CHIP-8-Org/Docs/README.md

# CHIP-8 STM32

The purpose of this project is to build a CHIP-8 and S-CHIP emulator capable of running on an STM32 microcontroller.
