CHIP-8-Org/Docs/report/report.tex

\documentclass[a4paper]{article}

\usepackage{showcode/showcode}
\usepackage{multicol}
\usepackage{blindtext}
\usepackage{amssymb}
\usepackage{amsthm}
\usepackage{mathtools}
\usepackage{bm}

\usepackage[a4paper]{geometry}
\usepackage[hidelinks]{hyperref}
\usepackage{eurosym}
\usepackage{caption, subcaption}
\usepackage{tikz, circuitikz}
\usepackage{pgf-umlcd, pgf-umlsd}
\usepackage[italian]{babel} % FIXME
\usepackage[utf8]{inputenc}
\usepackage[T1]{fontenc}
\usepackage[normalem]{ulem}
\usepackage[titletoc]{appendix}
\usepackage{listings}

\lstdefinelanguage{CHIP8}{
  morekeywords={loop, again, sprite, key, random, if, then},
  sensitive=true,
}

\lstset{
  language=CHIP8,
  basicstyle=\ttfamily,
  keywordstyle=\bfseries,
  frame=single,
  numbers=left,
  stepnumber=1,
  numbersep=5pt,
  breaklines=true,
  breakatwhitespace=true,
}

\renewcommand{\umltextcolor}{black}
\renewcommand{\umldrawcolor}{black}
\renewcommand{\umlfillcolor}{white}

\definecolor{type}{RGB}{132, 42, 17}

\textwidth=450pt
\oddsidemargin=0pt
\textheight=665pt
\voffset=-50pt

\begin{document}

\begin{titlepage}
    \begin{center}
        

        \vspace*{1.75cm}

        \LARGE

        \textbf{MSc in Computer Science} \\
        at University of Milan

        \vspace*{1cm}

        \huge
        Emulatore CHIP-8 su STM32

        \large Relazione per il progetto di PROS, \\
        corso tenuto da \textbf{Danilo Bruschi}

        \normalsize
        \vspace*{4cm}

        \begin{minipage}[t]{0.47\textwidth}
            {\large \href{federico.bruzzone@studenti.unimi.it}{federico.bruzzone@studenti.unimi.it}} \vspace{1em}  \\
            {\large \href{lorenzo.ferrante1@studenti.unimi.it}{lorenzo.ferrante1@studenti.unimi.it}} \vspace{1em}  \\
            {\large \href{andrea.longoni3@studenti.unimi.it}{andrea.longoni3@studenti.unimi.it}} \vspace{1em}  \\
        \end{minipage}
        \hfill
        \begin{minipage}[t]{0.47\textwidth}\raggedleft
            {\large \textbf{Federico Bruzzone}} \\
            \vspace{1em}
            {\large \textbf{Lorenzo Ferrante}} \\
            \vspace{1em}
            {\large \textbf{Andrea Longoni}}
        \end{minipage}

        \vfill
        Anno accademico 2022/2023

    \end{center}
\end{titlepage}
\setlength{\parindent}{0pt}
\setlength{\parskip}{0.8em}

\tableofcontents
\listoffigures
\listoftables

\clearpage

\begin{center}
\fbox{
    \begin{minipage}{0.9\textwidth}
    \footnotesize\itshape
    Abbiamo deciso di creare un'organizzazione GitHub per rendere accessibile il codice
    sorgente del nostro progetto ad altri programmatori open-source coinvolti con lo sviluppo
    di emulatori e con la community online di CHIP-8.
    \\
    \\
    Link all'organizzazione:
    \begin{itemize}
        \item Macchina virtuale: \url{https://github.com/CHIP-8-Org/Core}
        \item Port su STM32: \url{https://github.com/CHIP-8-Org/STM32-Port}
        \item Documentazione: \url{https://github.com/CHIP-8-Org/Docs}
    \end{itemize}
    \end{minipage}
}
\end{center}

\section{Introduzione}

CHIP-8 è un linguaggio di programmazione creato a metà degli anni '70
da Joseph Weisbecker per semplificare lo sviluppo di videogiochi per
microcomputer a 8 bit. I programmi CHIP-8 vengono interpretati da una
macchina virtuale che è stata estesa parecchie volte nel corso degli
anni, tra le versioni più adottate citiamo S-CHIP e la più recente
XO-CHIP.

La semplicità dell'interprete in aggiunta alla sua lunga storia e
popolarità hanno fatto sì che emulatori e programmi CHIP-8 vengano
realizzati ancora oggi.
Nel corso degli anni molti videogiochi storici sono stati riscritti
in CHIP-8 tra cui Pong, Space Invaders e Tetris.

Lo scopo del progetto è quello di realizzare un emulatore CHIP-8 e
S-CHIP in grado di funzionare su un microcontrollore STM32.

In questo documento ci riferiremo alla macchina virtuale che
interpreta programmi CHIP-8 con "interprete". Mentre utilizzeremo
"emulatore" per indicare l'interprete assieme ad una sua
implementazione (o "port"), ovvero un programma che gestisce
l'audio, il video, l'input da tastiera e interagisce con l'API della
macchina virtuale.

\section{Stato dell'arte}

Al giorno d'oggi risulta difficile ottenere un numero esatto di utenti che
utilizzano CHIP-8,un buon indicatore può essere il topic "chip8" di GitHub
che raggruppa quasi un migliaio di repository.

Tra queste la più popolare è Octo, un'implementazione scritta in JavaScript
capace di eseguire la versione base di CHIP-8, S-CHIP e XO-CHIP nel browser.
La repository è mantenuta da John Earnest, l'inventore di XO-CHIP che nel 2014
ha riportato in vita CHIP-8 modernizzandolo e aggiungendo nuove funzionalità.

Inoltre ogni anno viene organizzata la Octojam, una game jam dove ogni partecipante
prova a sviluppare un videogioco per CHIP-8 (o per le sue estensioni) partendo da zero.

Grazie al suo instruction set ridotto e alla sua limitata richiesta di risorse hardware
è stato portato su un elevato numero di piattaforme, tra cui il Game Boy Color, calcolatrici
grafiche serie HP 48 e Emacs (il famoso editor di testo).

Sebbene CHIP-8 e S-CHIP siano stati tradizionalmente implementati tramite software
esistono anche implementazioni hardware. Ne citiamo una in particolare scritta nel
linguaggio Verilog per schede FPGA.

\clearpage

\section{Hardware}\label{sec:hardware}

\begin{figure}[h!t]
    \begin{subfigure}[b]{0.45\textwidth}
        \begin{center}
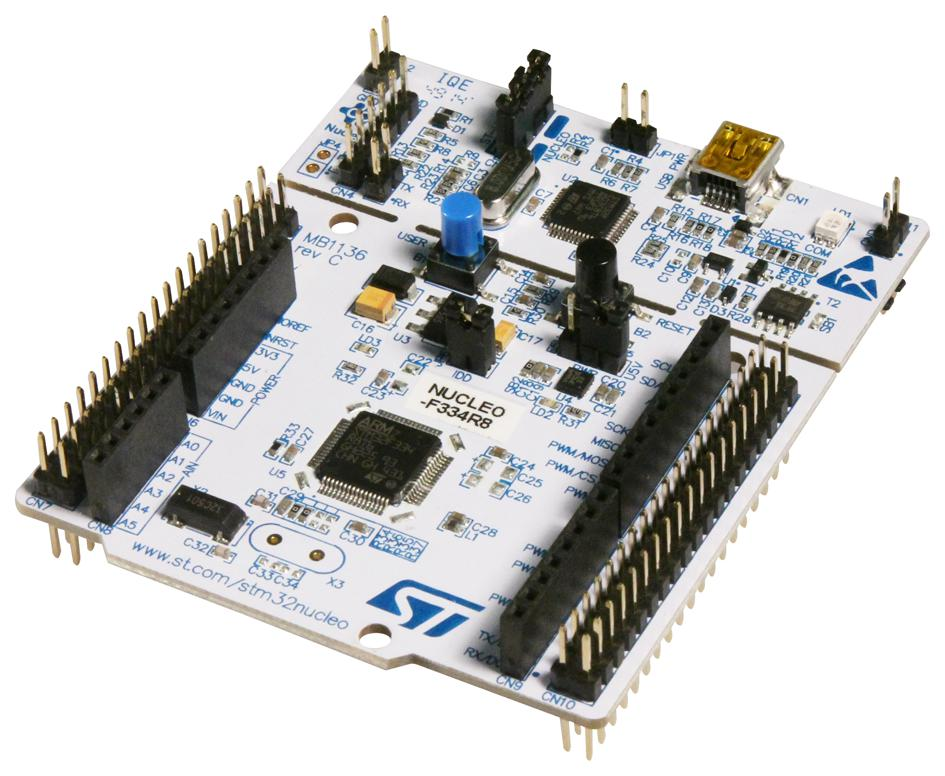
[picture p1: report/figures/stm32f334.jpg]
            
        \end{center}
        \caption{Il microcontrollore \texttt{STM32F334R8T6}.}
        \label{fig:stm32f334}
    \end{subfigure}
    \hfill
    \begin{subfigure}[b]{0.45\textwidth}
        \begin{center}
            \begin{tikzpicture}[x=0.015cm, y=0.015cm, scale=0.50, transform shape]
                \input{figures/stm32f334.tex}
            \end{tikzpicture}
        \end{center}
        \caption{Pinout del microcontrollore \texttt{STM32F334R8T6}.}
        \label{fig:pinout_stm32}
    \end{subfigure}
\end{figure}

Il componente hardware principale è il microcontrollore \texttt{STM32F334R8T6}
(Fig. \ref{fig:stm32f334}), equipaggiato con un processore ARM Cortex-M4
da 72 MHz, 16 Kb di SRAM e 64 Kb di memoria flash. Abbiamo deciso di utilizzare
questa scheda anziché quella fornitaci durante il corso (\texttt{STM32L053R8T6})
perché quest'ultima offriva una quantità di SRAM troppo limitata (solo 8 Kb).

In particolare le ROM dei giochi CHIP-8 possono arrivare a pesare fino a 3.5 Kb per questo
motivo è stato necessario utilizzare una scheda leggermente più potente.

\begin{figure}[h!t]
    \begin{subfigure}[b]{0.45\textwidth}
        \begin{center}
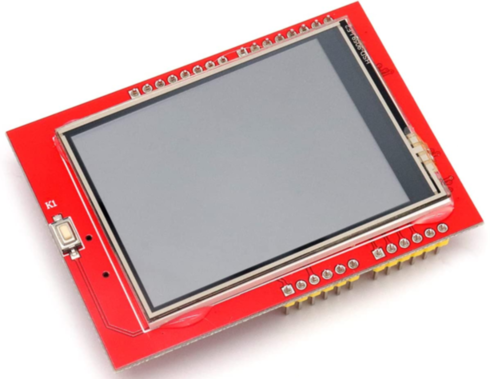
[picture p2: report/figures/ili9341.png]
            
        \end{center}
        \caption{Lo schermo ILI9341.}
        \label{fig:ili9341}
    \end{subfigure}
    \hfill
    \begin{subfigure}[b]{0.45\textwidth}
        \begin{center}
            \begin{tikzpicture}[x=0.015cm, y=0.015cm, scale=0.65, transform shape]
                \input{figures/ili9341.tex}
            \end{tikzpicture}
        \end{center}
        \caption{Pinout dello schermo \texttt{ILI9341}.}
        \label{fig:pinout_ili}
    \end{subfigure}
\end{figure}

Per quanto riguarda lo schermo dell'emulatore abbiamo optato per un display TFT LCD
a colori retroilluminato (Fig. \ref{fig:ili9341}) basato sul controller \texttt{ILI9341}.
Il display ha una dimensione di 2.4 pollici, una risoluzione di 320$\times$240 px e
al suo interno è presente un lettore di schede microSD integrato.

\clearpage

\begin{figure}[h!t]
    \begin{subfigure}[b]{0.45\textwidth}
        \begin{center}
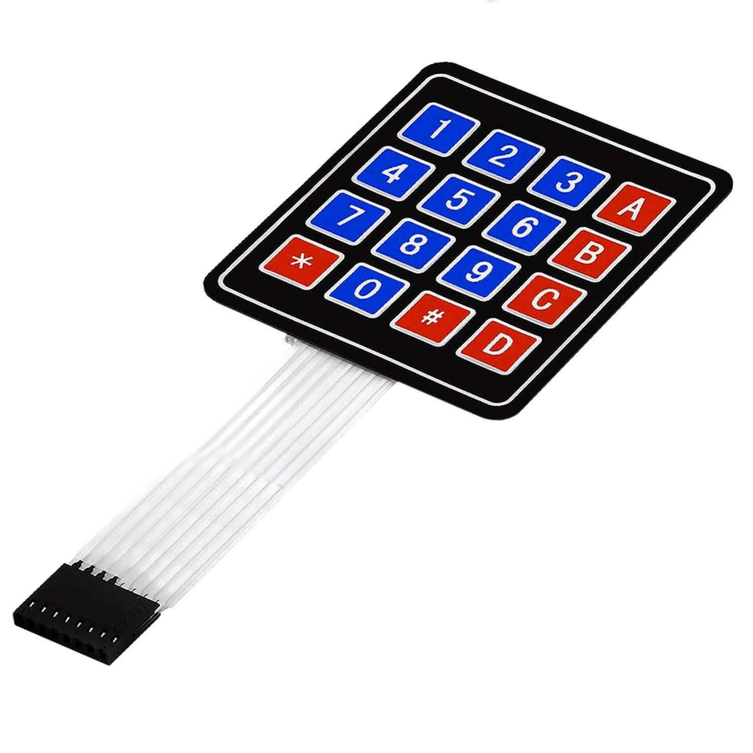
[picture p3: report/figures/4x4_keypad.jpeg]
            
        \end{center}
        \caption{Il tastierino matriciale 4$\times$4.}
        \label{fig:4x4_keypad}
    \end{subfigure}
    \hfill
    \begin{subfigure}[b]{0.45\textwidth}
        \begin{center}
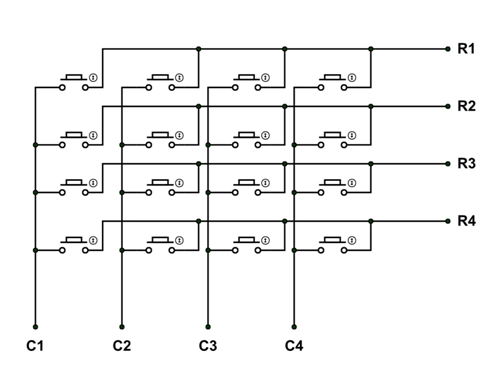
[picture p4: report/figures/4x4_keypad_structure.png]
            
        \end{center}
        \caption{Struttura del tastierino matriciale 4$\times$4.}
        \label{fig:4x4_keypad_structure}
    \end{subfigure}
\end{figure}

Per poter interagire con l'emulatore abbiamo utilizzato un tastierino matriciale 4$\times$4
(Fig. \ref{fig:4x4_keypad}) analogo alla tastiera originale del
COSMAC VIP \cite{wikipedia:cosmacvip}, un microcomputer creato da Joseph Weisbecker appositamente per CHIP-8.

Infine, per supportare gli effetti sonori riprodotti dai videogiochi CHIP-8 abbiamo
utilizzato un beeper passivo monotono, che anche essendo un dispositivo molto semplice
adempie correttamente ai suoi compiti dato che il suono prodotto da un emulatore CHIP-8
deve avere solo un tono.

\subsection{Componenti utilizzati e relativi costi}

\begin{table}[h!t] % [ht]
    \centering
    \begin{tabular}{|llll|l|}
        \hline
        \multicolumn{1}{|l|}{\textbf{Descrizione}}          & \multicolumn{1}{l|}{\textbf{Modello}}       & \multicolumn{1}{l|}{\textbf{Costo unitario}} & \textbf{Unità} & \textbf{Costo} \\ \hline
        \multicolumn{1}{|l|}{Microcontrollore}       & \multicolumn{1}{l|}{STM32 F334R8T6}         & \multicolumn{1}{l|}{14.99}                   & 1               & 14.99          \\ \hline
        \multicolumn{1}{|l|}{Schermo}                & \multicolumn{1}{l|}{ILI9341 2.4"}           & \multicolumn{1}{l|}{6.50}                    & 1               & 6.50           \\ \hline
        \multicolumn{1}{|l|}{Tastierino}          & \multicolumn{1}{l|}{Matrix keypad 4$\times$4} & \multicolumn{1}{l|}{3.99}                    & 1               & 3.99           \\ \hline
        \multicolumn{1}{|l|}{Beeper}                 & \multicolumn{1}{l|}{}                       & \multicolumn{1}{l|}{0.99}                    & 1               & 0.99           \\ \hline
        \multicolumn{1}{|l|}{Cablaggio} & \multicolumn{1}{l|}{}                       & \multicolumn{1}{l|}{4.99}                    & 1               & 4.99           \\ \hline
        \multicolumn{1}{|l|}{Interruttore e altri materiali} & \multicolumn{1}{l|}{}       & \multicolumn{1}{l|}{4.99}                    & 1               & 4.99           \\ \hline
        \multicolumn{1}{|l|}{Scocca} & \multicolumn{1}{l|}{GW42002}                       & \multicolumn{1}{l|}{9.99}                    & 1               & 9.99           \\ \hline
        \multicolumn{4}{|r|}{\textbf{Totale}}                                                      & 46.50\euro    \\ \hline
    \end{tabular}
    \caption{
        Materiali utilizzati per la realizzazione del progetto.
    }
    \label{tab:components}
\end{table}

In Tabella \ref{tab:components} è possibile vedere i componenti utilizzati per la
realizzazione del progetto. I costi indicati provengono da negozi online come Amazon e eBay.

\subsection{Schema di collegamento} \label{subsubsec:collegamenti}

\textbf{Legenda dei colori in Figura \ref{fig:schema}}

\begin{multicols}{2}
\begin{itemize}
    \item \textcolor{green}{Verde}: Schermo
    \item \textcolor{blue}{Blu}: Scheda microSD
    \item \textcolor{magenta}{Magenta}: Tastierino
    \item \textcolor{orange}{Arancione}: Beeper
    \item \textcolor{cyan}{Ciano}: Reset
    \item \textcolor{black}{Nero}: GND
    \item \textcolor{red}{Rosso}: Alimentazione
\end{itemize}
\end{multicols}

\clearpage

\begin{figure}[h!t]
    \begin{center}
        
    \end{center}
    \caption{
        Schema dei collegamenti.
    }
    \label{fig:schema}
\end{figure}

In Figura \ref{fig:schema} è possibile vedere lo schema di collegamento
dei componenti hardware realizzato utilizzando il software KiCad.
Il display e il lettore microSD integrato sono stati collegati al microcontrollore
attraverso il pinout standard degli Shields di Arduino, un'interfaccia hardware che permette
di collegare una scheda Arduino ad un modulo esterno.

Il tastierino matriciale 4$\times$4 è stato collegato al microcontrollore tramite 8 pin GPIO.
In particolare i 4 pin relativi alle righe (\texttt{R1}, \texttt{R2}, \texttt{R3}, \texttt{R4})
sono stati impostati in modalità \texttt{GPIO\_MODE\_IT\_RISING} (interrupt rising edge).

Quando un pin GPIO viene configurato come sorgente di interrupt sul fronte di salita
il segnale di interrupt è generato quando il pin passa da basso (0) ad alto (1), risultando
particolarmente utile per intercettare il cambiamento dello stato di un
pulsante quando viene premuto.

Invece, i 4 pin relativi alle colonne (\texttt{C1}, \texttt{C2}, \texttt{C3}, \texttt{C4})
sono stati impostati in modalità \texttt{GPIO\_MODE\_OUTPUT\_PP} (push-pull output) per
consentire l'invio dell'interrupt alla pressione di un tasto, dato che chiudendo il circuito
si permette alla corrente proveniente dal pin GPIO di fluire verso i pin di interrupt.
Successivamente viene identificato il tasto premuto, questo meccanismo verrà elaborato
nella sezione \ref{subsubsec:keypad}.

\clearpage

Infine, il beeper è stato collegato al microcontrollore tramite un pin GPIO e GND.
Quest'ultimo è stato impostato in modalità \texttt{GPIO\_MODE\_OUTPUT\_PP} (push-pull output)
per permettere l'invio di un segnale al beeper.

\section{Software}

Il nostro software si divide in due componenti principali: l'interprete CHIP-8 e
l'infrastruttura necessaria per "portarlo" sul microcontrollore STM32, ovvero l'interfaccia
con lo schermo e i gestori per la scheda microSD, per il keypad e per il beeper.

\subsection{Interprete CHIP-8} \label{subsec:intreprete}

\begin{Listing}[h!t] % [ht]
    \centering
    \showc*[.8\textwidth]{chip8_struct.c}
    \caption{La struct che rappresenta lo stato della macchina virtuale.}
    \label{chip8_struct}
\end{Listing}

Abbiamo deciso di scrivere l'interprete da zero e per farlo è stato necessario consultare
le specifiche (de facto standard) che definiscono il comportamento di un interprete CHIP-8
\cite{cowgod:chip8} e S-CHIP \cite{cowgod:schip}.

L'interprete ha un'architettura basata su registri e possiede 4 Kb di memoria, 16 registri
general purpose, un registro per gli indirizzi di memoria, un registro per il delay timer,
un registro per il sound timer, uno stack per gestire le chiamate a subroutine, uno stack pointer
e un program counter.

Il delay timer viene utilizzato come cronometro mentre il sound
timer è utilizzato per gestire gli effetti sonori, quando il suo
valore è diverso da zero, l'emulatore attiva il beeper.

Ad ogni ciclo di esecuzione l'interprete effettua il fetch
dell'istruzione puntata dal program counter in memoria,
la decodifica e la esegue.

Sono supportate 45 istruzioni diverse, ciascuna delle
quali è rappresentata da uno specifico opcode in cui al suo interno
sono passati anche eventuali parametri.

Il programma è scritto in C99, non ha I/O ed è freestanding
\cite{n1256:conformance}, ovvero non dipende dalla libreria
standard del C (libc). Tutto questo è mirato a rendere l'interprete
altamente portabile.

Per rimuovere la dipendenza da libc è stato necessario includere
alcune funzioni direttamente da libgcc, trovare un modo alternativo
per implementare le asserzioni e includere una funzione ad hoc per
la generazione di numeri casuali.

Le asserzioni sono gestite tramite una macro che verifica una condizione.
Se la condizione è falsa, viene dereferenziato un puntatore a NULL, terminando
così il programma. Si è utilizzato \texttt{volatile} per evitare possibili ottimizzazioni
del compilatore. Invece per quanto riguarda la generazione di numeri casuali è stato
adottato un LCG troncato \cite{wikipedia:lcg}, un generatore di numeri pseudo-casuali
molto comune.

\clearpage

\begin{Listing}[h!t]
    \centering
    \mbox{
        \showc[.45\textwidth]{assert.c}
        \quad
        \showc[.50\textwidth]{random.c}
    }
    \caption{Implementazioni di \texttt{ASSERT} e \texttt{rand\_byte}.}
    \label{assert_rand}
\end{Listing}

Infine per testare più comodamente l'interprete abbiamo sviluppato
un semplice emulatore su desktop utilizzando SDL2
\cite{libsdl:about}, una libreria scritta in C che consente di
gestire audio, video e input da tastiera.
In seguito l'interprete è stato sottoposto ad un'apposita
test suite \cite{github:chip8-test-suite} che mira a verificare
il comportamento corretto di ciascun opcode.

\subsubsection{Gestione del timing}

Uno dei problemi principali durante lo sviluppo di un emulatore è
la gestione del timing, in particolare è necessario limitare la
"velocità" dell'emulatore bloccando temporaneamente la sua
esecuzione.

Inoltre abbiamo dovuto disaccoppiare la frequenza dell'interprete
(regolabile dal giocatore) dalla frequenza del delay timer e del
sound timer (costante a 60 Hz). Dove con frequenza dell'interprete
ci riferiamo al numero di istruzioni che esegue ogni frame.

Inizialmente abbiamo optato per la gestione di una singola istruzione per ciclo di esecuzione,
di conseguenza il ritardo del game loop risultava variabile e dipendeva dalla frequenza selezionata
dal giocatore. Per assicurare una frequenza $\mathcal{F}$ di 60 Hz i timer venivano decrementati
ogni n-esima iterazione del game loop, dove $n = \frac{\mathcal{F}}{60}$. Ad esempio se
$\mathcal{F} = 540$, i timer venivano decrementati ogni $9^{\circ}$ ciclo.

Purtroppo però questo approccio presenta un problema non trascurabile, ovvero effettua una chiamata
ad una funzione simil-sleep per un periodo molto breve dopo ogni istruzione. Ad esempio se
$\mathcal{F} = 540$, il ritardo di una sleep sarebbe solo di 1.85 ms, e questo genere di funzione
non offre una precisione simile. Per questo motivo abbiamo optato per una soluzione differente.

Abbiamo fissato il ritardo del game loop a 16.666 ms, un valore sufficientemente alto da non avere
problemi di granularità. Inoltre in questo modo otteniamo un frame rate di 60 FPS esatti.
Avendo reso il ritardo costante abbiamo dovuto rendere variabile il numero di istruzioni gestite
durante un ciclo di esecuzione. In particolare vengono gestite n istruzioni per ciclo,
dove $n = \frac{\mathcal{F}}{60}$. Ad esempio se $\mathcal{F} = 540$, vengono gestite 9 istruzioni
per ciclo. A questo punto dato che il game loop viene ripetuto con una frequenza di 60 Hz risulta
banale gestire la frequenza dei timer.

Sono state considerate anche eventuali problematiche che sarebbero potute sorgere con questo
approccio. In particolare non tutte le istruzioni impiegano lo stesso tempo per essere eseguite,
ma fortunatamente anche l'istruzione più lenta richiede una quantità trascurabile di tempo.
Ciò significa che possiamo comportarci come se tutte le istruzioni richiedessero il medesimo tempo.

\subsubsection{Ottimizzazioni}

È stato necessario introdurre delle ottimizzazioni all'interno
dell'interprete per poterlo far girare su un microcontrollore.

L'ottimizzazione principale è legata alla rappresentazione dello
schermo in memoria. Ad alto livello lo schermo può essere visto
come una matrice di 128x64 pixel monocromi. Una rappresentazione
simile occuperebbe 8192 byte, dato che ciascun pixel verrebbe
rappresentato da un byte.

Purtroppo il nostro microcontrollore ha a disposizione solamente 16 Kb di SRAM, di conseguenza
una soluzione simile non è praticabile.

\clearpage

Per questo motivo abbiamo deciso di rappresentare lo schermo come un array unidimensionale di
1024 byte, dove ciascun pixel viene rappresentato da un singolo bit. In questo modo otteniamo
un risparmio di spazio pari a ben l'87.5\%.

Questa decisione ha aggiunto però un livello di indirezione dato
che una coordinata ad alto livello sulla matrice 128x64 deve essere
mappata ad una coordinata "in memoria".

\begin{figure}[h!t]
    \begin{center}
        % \includegraphics[scale=0.3]{figures/screenopt.pdf}
        
    \end{center}
    \caption{Esempio della mappatura di un pixel.}
    \label{fig:screenopt}
\end{figure}

Un'ulteriore ottimizzazione viene resa disponibile attraverso l'API
dell'interprete sotto forma di una funzione che consente al chiamante
di controllare se l'array che rappresenta lo schermo è stato
modificato nell'ultimo ciclo di esecuzione. In questo modo la grafica
viene renderizzata dal chiamante solo quando è effettivamente
necessario.

\subsubsection{Comportamenti ambigui}

Gli interpreti CHIP-8 e S-CHIP hanno sviluppato molteplici
comportamenti ambigui nel corso degli anni. Questi cosiddetti
"quirk" variano in base alle piattaforme per cui è stato sviluppato
l'interprete. Ad esempio gli interpreti per calcolatrici HP 48
presentano un comportamento leggermente diverso durante l'esecuzione
delle istruzioni di SHIFT.

Questi comportamenti ambigui si propagano fino ai programmatori
CHIP-8 che si appoggiano a quest'ultimi e scrivono videogiochi che
non sono del tutto compatibili con interpreti più vecchi. Per evitare
questa frammentazione è necessario supportare le piattaforme
principali e i loro quirk.

Il nostro interprete supporta CHIP-8, CHIP-48, S-CHIP 1.0 e
S-CHIP 1.1, in questo modo è in grado di eseguire la stragrande
maggioranza dei videogiochi reperibili in rete.

\subsection{Porting su STM32}

Dopo aver terminato l'interprete abbiamo sviluppato un'infrastruttura per poterlo eseguire
sul microcontrollore STM32.

Come già anticipato, l'infrastruttura si compone di un'interfaccia con lo schermo,
un gestore per la scheda microSD, un gestore per il tastierino e un gestore per il beeper.

È importante ricordare che l'interprete è stato progettato per essere altamente portabile
e indipendente dalla piattaforma su cui verrà eseguito, per questo motivo non è stato necessario
apportare modifiche significative.

Tuttavia, a causa della potenza limitata della scheda la fluidità del gameplay è inferiore
rispetto alla port su SDL2 che viene eseguita su normale computer.

\clearpage

\subsubsection{Architettura software}

\begin{figure}[h!t]
    \begin{center}
        \begin{tikzpicture}[scale=0.6, transform shape]
            \input{figures/class_diagram.tex}
        \end{tikzpicture}
    \end{center}
    \caption{
       Class diagram.
    }
    \label{fig:class_diagram}
\end{figure}

In Figura \label{fig:class_diagram} è rappresentato il class diagram, il quale offre una panoramica
dell'architettura del software. Una differenza da evidenziare rispetto alla proposta iniziale
è che la classe \texttt{menù} non è più presente perché è stata integrata all'interno della
classe \texttt{main}.

\begin{figure}[h!t]
    \begin{center}
        \input{figures/sequence_diagram.tex}
    \end{center}
    \caption{
        Sequence diagram.
    }
    \label{fig:sequence_diagram}
\end{figure}

Il flusso di esecuzione dell'emulatore è mostrato in Figura \ref{fig:sequence_diagram},
per prima cosa vengono letti i nomi dei file presenti sulla scheda microSD, in seguito
si entra nel game selection loop dove il giocatore potrà selezionare un gioco, la velocità
dell'interprete e la piattaforma da emulare. Una volta selezionato il gioco si entrerà nel
game loop dove inizia la fase di emulazione vera e propria.

\subsubsection{Interfaccia con la scheda microSD}\label{subsubsec:sd}

La scheda microSD è utilizzata come memoria di massa dell'emulatore contenente i file
binari dei videogiochi CHIP-8. È stata formattata con FAT32 e viene gestita utilizzando
FatFs \cite{elm-chan:fatfs}, una libreria open source che permette di interfacciarsi
con questa tipologia di filesystem.

La comunicazione tra il microcontrollore e la scheda microSD avviene tramite il protocollo
Serial Peripheral Interface (SPI), dove il microcontrollore è configurato come
master e la scheda microSD come slave.

\subsubsection{Menù di selezione}

La selezione del gioco avviene tramite un apposito menù che lista su più pagine tutti i giochi
presenti sulla scheda microSD. Per aggiungere un gioco è sufficiente caricarlo sulla scheda
microSD e riavviare il microcontrollore, poiché il menu viene generato dinamicamente.
Inoltre, il menù permette anche di impostare la velocità e la modalità di esecuzione
dell'interprete.

L'utente interagisce con il menù attraverso il tastierino, in particolare abbiamo predisposto
dei tasti riservati per la navigazione tra le pagine, per la selezione della velocità e
della modalità di esecuzione. I tasti rimanenti vengono utilizzati per avviare specifici giochi.

Infine, per risolvere il problema degli artefatti grafici al cambio di schermata,
abbiamo implementato una funzione dedicata per "pulire" lo schermo e ottenere un effetto
di transizione da una schermata all'altra.

\subsubsection{Rendering del font}

\begin{figure}[h!t]
    \begin{center}
        
    \end{center}
    \caption{Esempio della mappatura di un carattere del font.}
    \label{fig:matrix_font}
\end{figure}

Per poter mostrare  sullo schermo  i nomi dei giochi caricati sulla scheda microSD è
necessario l'utilizzo di un font. Abbiamo scelto un font che rappresenta ciascun carattere
come una bitmap, ossia una matrice $8 \times 10$ pixel rappresentata da 10 interi ad 8 bit.

Nella Figura \ref{fig:matrix_font}, è mostrata una rappresentazione grafica di questa matrice.
Ogni riga è un intero a 8 bit, dove i bit a 1 corrispondono ai pixel neri. Ad esempio,
la prima riga è rappresentata dal numero 56, che in binario è \texttt{00111000}.

\clearpage

\subsubsection{Funzionamento del keypad}\label{subsubsec:keypad}

Inizialmente il keypad è stato gestito tramite polling, dove il microcontrollore verificava
continuamente lo stato dei pin per identificare il tasto premuto. Tuttavia, questo approccio
è stato abbandonato in favore di un approccio basato su interrupt. Il polling richiedeva
molte risorse e non garantiva un framerate stabile, poiché non riusciva a leggere tutti
i pin e completare le operazioni rimanenti entro il limite di ~16 ms imposto dal frame rate
dell'emulatore (60 FPS).

La procedura standard per gestire gli interrupt su microcontrollori STM32 coinvolge
la configurazione di un pin GPIO come sorgente di interrupt e l'implementazione di
una funzione per la gestione di un interrupt. Per poter generare un interrupt quando
un tasto viene premuto abbiamo impostato i pin di riga in modalità \texttt{GPIO\_MODE\_IT\_RISING}
e i pin di colonna in modalità \texttt{GPIO\_MODE\_OUTPUT\_PP}, come già accennato nella
sezione \ref{subsubsec:collegamenti}.

% FIXME
%
% Successivamente, viene capito quale tasto è stato premuto, leggendo il valore dei pin
% di riga e di colonna. Per fare ciò, i pin di riga sono stati impostati in modalità
% \texttt{GPIO\_MODE\_INPUT}. Come si può vedere nel listato \ref{keypad} a riga 1,
% nella routine di interrupt viene abilitato il pin di output della prima colonna e in seguito
% per ogni riga viene letto il valore del pin di input per conoscere la seconda coordinata
% del tasto premuto, e in caso sia premuto viene salvato nella struttura dati apposita
% nella macchina virtuale. Questa operazione viene ripetuta per ognuna delle quattro colonne.
% Al termine della routine di interrupt i pin di riga vengono re-impostati in modalità
% \texttt{GPIO\_MODE\_IT\_RISING} per permettere l'invio dell'interrupt alla pressione
% di un nuovo tasto.
%
% \begin{Listing}[h!t] % [ht]
%     \centering
%     \setminted[c]{escapeinside=@@}
%     \showc*[.87\textwidth]{keypad.c}
%     \caption{Gestione dell'interrupt del keypad.}
%     \label{keypad}
% \end{Listing}

\subsubsection{Interfaccia con lo schermo}

La comunicazione con il controller ILI9341 può avvenire tramite due interfacce diverse:
SPI oppure parallela ad 8 bit. L'interfaccia SPI richiede meno pin ma è più lenta
a causa del suo protocollo seriale, mentre l'interfaccia parallela è più veloce ma
richiede più pin. La decisione di quale interfaccia utilizzare viene presa direttamente
dal produttore che espone solamente alcuni dei pin del circuito integrato. Poiché il display
dovrà essere aggiornato 60 volte al secondo abbiamo deciso di acquistare la versione dello
schermo che supporta l'interfaccia parallela.

Durante la fase di inizializzazione i pin di controllo della scheda
(\texttt{LCD\_RD}, \texttt{LCD\_WR}, \texttt{LCD\_RS}, \texttt{LCD\_CS}, \texttt{LCD\_RST})
vengono impostati in modalità \texttt{GPIO\_MODE\_OUTPUT\_PP} tramite le funzioni messe a
disposizione dall'HAL.

Inoltre, prima di inviare la sequenza di inizializzazione al display, vengono disabilitati i pin
\texttt{LCD\_WR} e \texttt{LCD\_RD} e viene impostato il pin \texttt{LCD\_CS} a
\texttt{LOW} (il controller \texttt{ILI9341} è attivo basso).

Il pin \texttt{LCD\_RST} permette di resettare lo stato interno del display, per questo
motivo viene attivato e disattivato all'avvio in modo tale da impostare la scheda in uno
stato conosciuto. Questo pin rimarrà disabilitato per l'intera durata dell'esecuzione.

Nel momento in cui la scheda raggiunge uno stato conosciuto bisogna inviare una sequenza di
comandi per attivare il display, questa sequenza di inizializzazione è spiegata dettagliatamente
nel datasheet dello schermo \cite{ili9341}.

Infine, per ottimizzare le prestazioni, abbiamo deciso di modificare il modo in cui stampiamo
sullo schermo. Inizialmente la funzione che gestisce la stampa a schermo si appoggiava
all'HAL, questo purtroppo generava un overhead non trascurabile che rallentava molto
l'emulatore. Per risolvere questo problema abbiamo deciso di non appoggiarci più all'HAL e
di scrivere la funzione in bare metal.

% FIXME
%
% Per risolvere questo problema abbiamo deciso di implementare due funzioni in bare metal.
%
% Entrambe le funzioni impostano il pin GPIO che gli viene passato come argomento ad
% uno stato \texttt{LOW} o \texttt{HIGH} rispettivamente. Eseguiamo questa azione scrivendo
% nel registro BSRR (come mostrato nel capitolo 9.4.7 in \cite{STM32F334xx}) (Bit Set/Reset Register).
% Nel caso della funzione \texttt{HIGH}, quando si scrive un 1 in un bit del registro BSRR,
% il corrispondente pin viene impostato su \textit{high}, mentre se si scrive un 0, il pin viene
% lasciato invariato. Nel caso di quella \texttt{LOW}, si accede sempre al registro BSRR,
% ma questa volta si utilizzano i bit superiori (da 16 a 31) per impostare il pin a \textit{low}.
%
% \begin{Listing}
%     \centering
%     \mbox{
%         \showc[.45\textwidth]{pin_low_metal.c}
%         \quad
%         \showc[.50\textwidth]{pin_high_metal.c}
%     }
%     \caption{Implementazioni bare metal di \texttt{pin\_low} e \texttt{pin\_high}}
%     \label{bare_metal_pins}
% \end{Listing}

\clearpage

\section{Assemblaggio}

\begin{figure}[h!t]
    \begin{center}
        % \includegraphics[scale=0.3]{figures/screenopt.pdf}
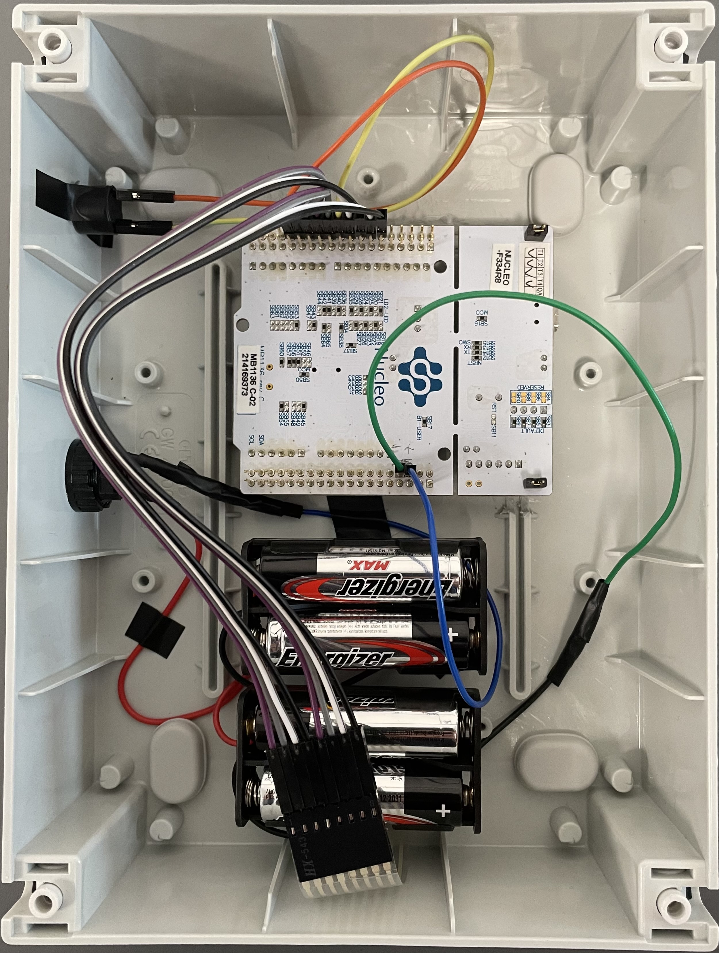
[picture p5: report/figures/end1.jpg]
        
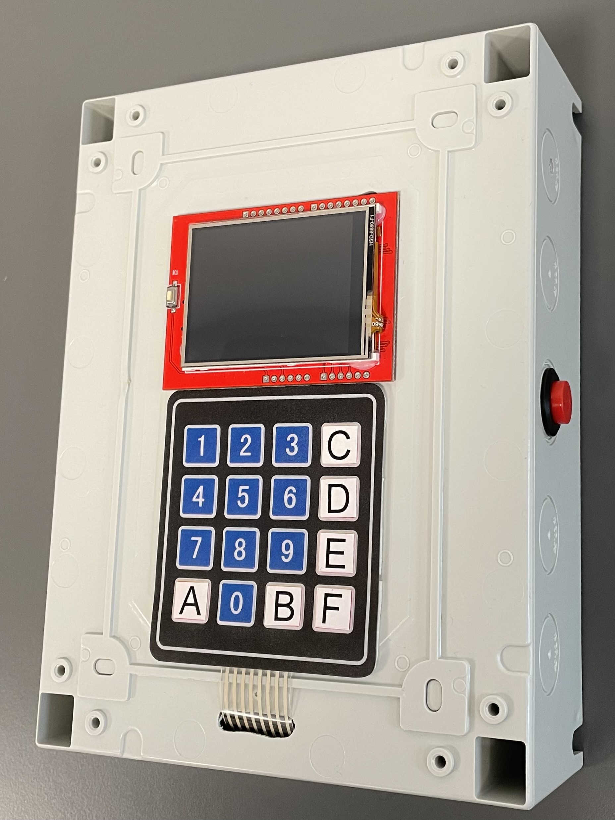
[picture p6: report/figures/end2.jpg]
        
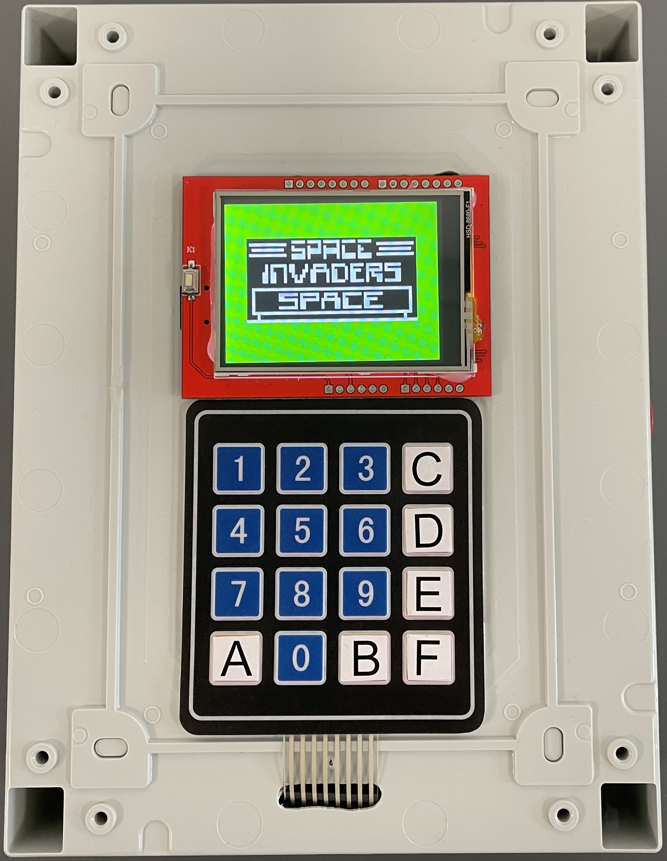
[picture p7: report/figures/end3.jpg]
        
    \end{center}
    \caption{Assemblaggio finale.}
    \label{fig:assemblaggio}
\end{figure}

Una volta terminato lo sviluppo del software abbiamo deciso di inserire i componenti hardware
all'interno di un guscio protettivo, in modo da nascondere il cablaggio e i vari pin scoperti,
lasciando accessibili solamente le parti con cui il giocatore interagisce direttamente.

Il guscio protettivo è stato realizzato con una base di supporto polifunzionale \cite{gewiss}
a cui sono state apportate le modifiche appropriate per essere in grado di "montare" correttamente
il display e il tastierino. Inoltre sono stati effettuati due fori sulla scocca per poter sentire
più facilmente il beeper e per poter accedere ad un interruttore per l'accensione e spegnimento
della scheda.

I collegamenti sono rimasti identici a quelli descritti nella sezione
\ref{subsubsec:collegamenti}, è stata però aggiunta una batteria esterna.

Infine, come ultimo tocco puramente estetico, abbiamo applicato degli adesivi al tastierino
per ricoprire i tasti che non corrispondevano a quelli originali del COSMAC VIP.

Consideriamo il risultato finale accettabile come prototipo iniziale, ma se si volesse
commercializzare un prodotto simile sarebbe imperativo utilizzare una PCB ad hoc più compatta,
un guscio su misura e un tastierino di qualità superiore.

\clearpage

\section{Analisi del consumo energetico}

La scheda \texttt{STM32F334R8T6} può essere alimentata sia tramite un cavo USB che mediante
una batteria esterna; per rendere l'emulatore portatile abbiamo scelto quest'ultima
soluzione utilizzando 4 batterie AA da 1.5 V ciascuna. Per passare dall'alimentazione USB a
quella esterna abbiamo dovuto muovere il jumper JP5 dalla posizione 1-2 alla posizione 2-3
\cite{stm32:usermanual}. Successivamente, abbiamo collegato le batterie in serie e connesso
il polo positivo al pin E5V e il polo negativo al pin GND della scheda.

Per ottenere una stima dell'autonomia dell'emulatore, abbiamo analizzato il suo consumo
energetico utilizzando il software STM32CubeIDE. Il consumo energetico della scheda è di
circa 30 mAh, mentre quello del display retroilluminato si aggira intorno ai 90 mAh.
Quindi, complessivamente, l'emulatore consuma all'incirca 120 mAh.

Assumendo che le batterie abbiano una capacità di 2500 mAh, ci aspettiamo che
l'emulatore possa rimanere acceso per circa 20 ore.

\begin{equation*}
    \begin{aligned}
        \textmd{tempo} & = \frac{\textmd{capacità}}{\textmd{consumo}} & = \frac{2500}{120} & = 20
    \end{aligned}
\end{equation*}

\section{Considerazioni finali}

Siamo riusciti a realizzare un emulatore CHIP-8 e S-CHIP in grado di funzionare su un
microcontrollore STM32 raggiungendo così l'obiettivo che ci eravamo prefissati.

Alcuni videogiochi purtroppo non hanno un gameplay fluido a causa della potenza
limitata della scheda, nonostante questo Tetris, Blitz, Tic-tac-toe e altri giochi
analoghi hanno prestazioni più che accettabili.

Infine, per quanto riguarda possibili sviluppi futuri abbiamo ipotizzato che si potrebbe
ulteriormente ottimizzare il software modificando l'interprete in modo tale da interagire
direttamente con il display, perdendo però così la sua portabilità.

\clearpage

\addcontentsline{toc}{section}{Riferimenti bibliografici}
\bibliographystyle{plain}
\bibliography{report}

\clearpage

\begin{appendices}
\section{Che aspetto ha un programma CHIP-8?}

I programmi CHIP-8 ricordano vagamente il linguaggio Assembly, ma le loro istruzioni non
sono mappate 1:1 ad istruzioni macchina eseguibili da un processore reale. Invece, vengono
mappate a bytecode interpretabile da una macchina virtuale (\ref{subsec:intreprete}).

Al giorno d'oggi la maggior parte dei programmatori CHIP-8 utilizza Octo \cite{chip8:octo}, un IDE
online scritto in JavaScript, che include un assemblatore per tradurre i programmi in bytecode
e una macchina virtuale per eseguirli.

Di seguito è riportato un programma CHIP-8 d'esempio:

\begin{lstlisting}[language=CHIP8]
:alias px v1
:alias py v2

: main
  px := random 0b0011111
  py := random 0b0001111
  i  := person
  sprite px py 8

  loop
    sprite px py 8
    v0 := 5 if v0 key then py += -1
    v0 := 8 if v0 key then py +=  1
    v0 := 7 if v0 key then px += -1
    v0 := 9 if v0 key then px +=  1
    sprite px py 8

    loop
      vf := delay
      if vf != 0 then
    again
    vf := 3
    delay := vf
  again

: person
  0x70 0x70 0x20 0x70 0xA8 0x20 0x50 0x50
\end{lstlisting}

\end{appendices}

\end{document}
