CHIP-8-Org/Docs/report/figures/sequence_diagram.tex

\resizebox{0.6\textwidth}{!}{%
        \begin{sequencediagram}
        \newthread{main}{:Main}
        % \newinst[0.5]{menu}{:Menu}
        \newinst[0.5]{vm}{:VM}
        \newinst[0.5]{lcd}{:ILI9341}
        \newinst[0.5]{kp}{:Keypad}
        \newinst[0.5]{beep}{:Beeper}
        \newinst[0.5]{fatfs}{:FatFS}

        \begin{call}{main}{mount(); readdir()}{fatfs}{}
        \end{call}
        \begin{sdblock}{Game Selection Loop}{}
            \begin{call}{main}{drawMenu()}{lcd}{}
            \end{call}
            \begin{call}{main}{interrupt()}{kp}{}
            \end{call}
        \end{sdblock}
        \begin{call}{main}{open(); read()}{fatfs}{}
        \end{call}

        \begin{call}{main}{init()}{vm}{}
        \end{call}

        \begin{sdblock}{Game Loop}{}
            \begin{call}{main}{cycle()}{vm}{}
            \end{call}
            \begin{call}{main}{drawGame()}{lcd}{}
            \end{call}
            \begin{call}{main}{interrupt()}{kp}{}
            \end{call}
            \begin{call}{main}{high() / low()}{beep}{}
            \end{call}
        \end{sdblock}
        \end{sequencediagram}
    }
