CHIP-8-Org/Docs/presentation/assets/costi.png

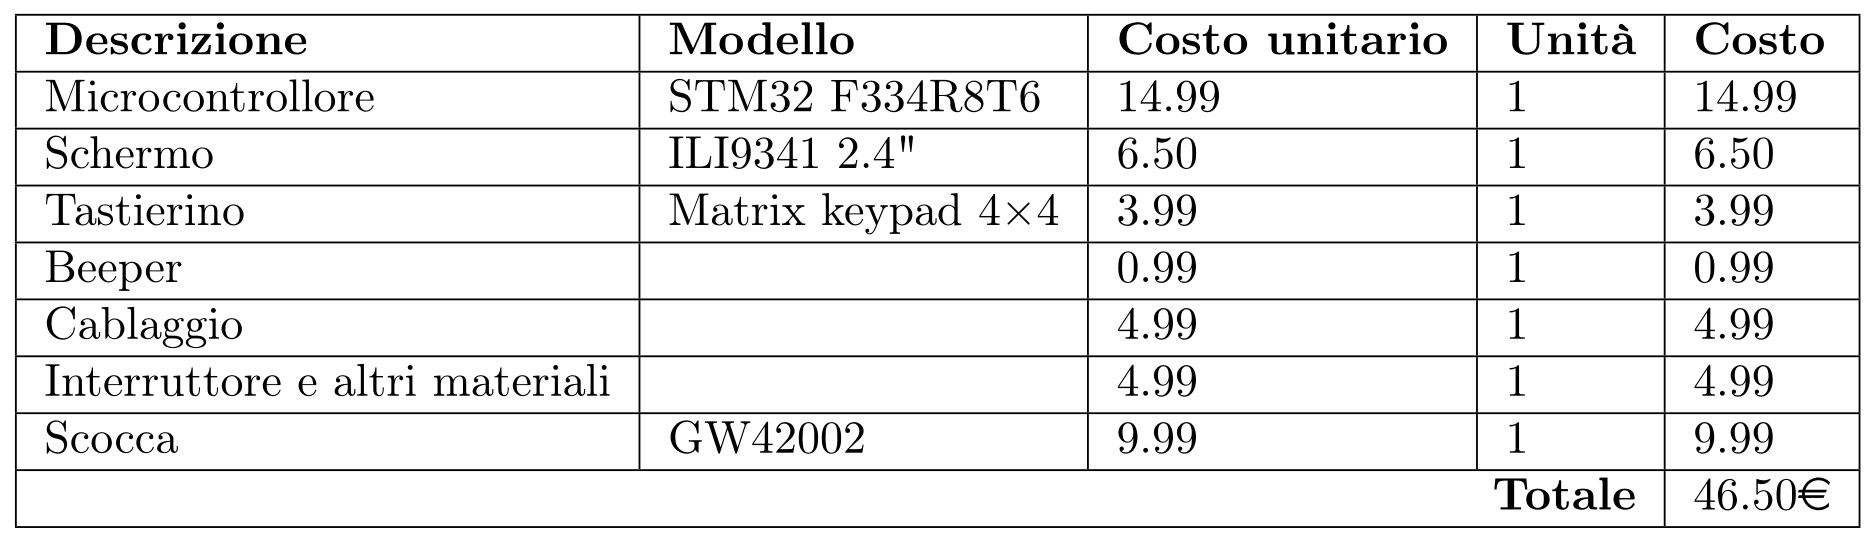
presentation/assets/costi.png
