CHIP-8-Org/Docs/presentation/assets/font.png

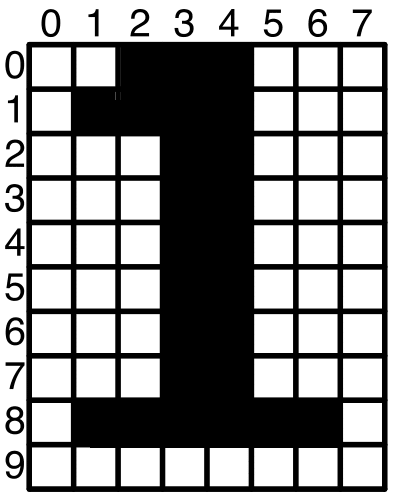
presentation/assets/font.png
