CHIP-8-Org/Docs/presentation/assets/menu2.jpg

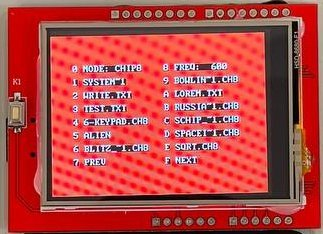
presentation/assets/menu2.jpg
