CHIP-8-Org/Docs/presentation/assets/menu.jpg

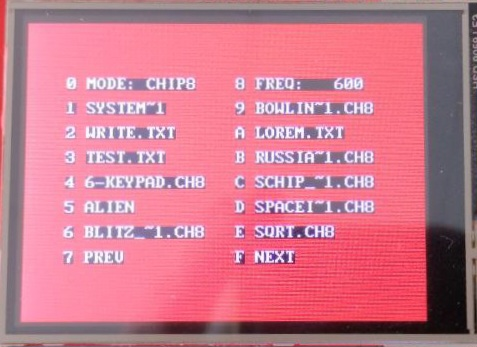
presentation/assets/menu.jpg
