CHIP-8-Org/Docs/presentation/assets/STM32_CHIP8-1.png

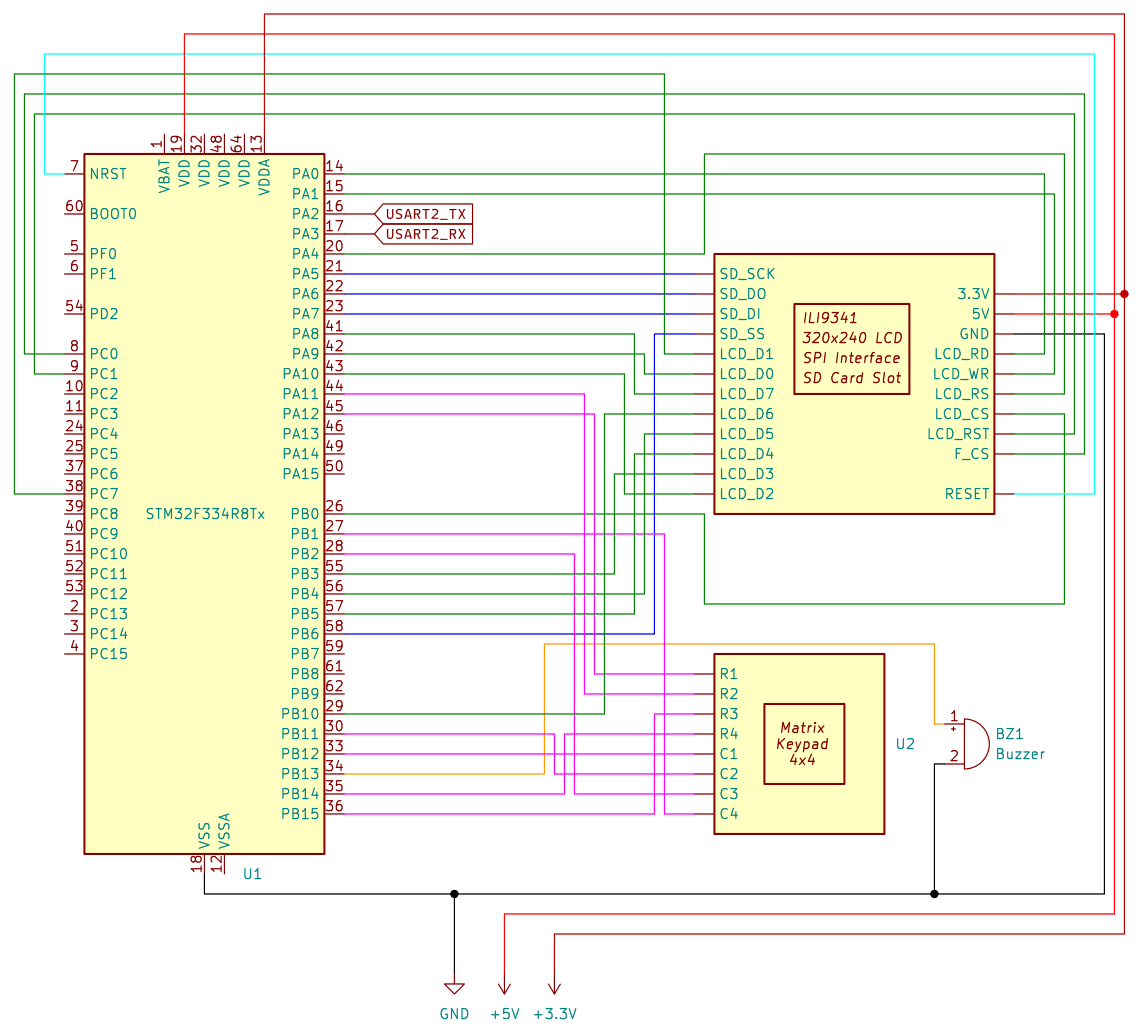
presentation/assets/STM32_CHIP8-1.png
