CHIP-8-Org/Docs/report/figures/STM32_CHIP8_OG.pdf

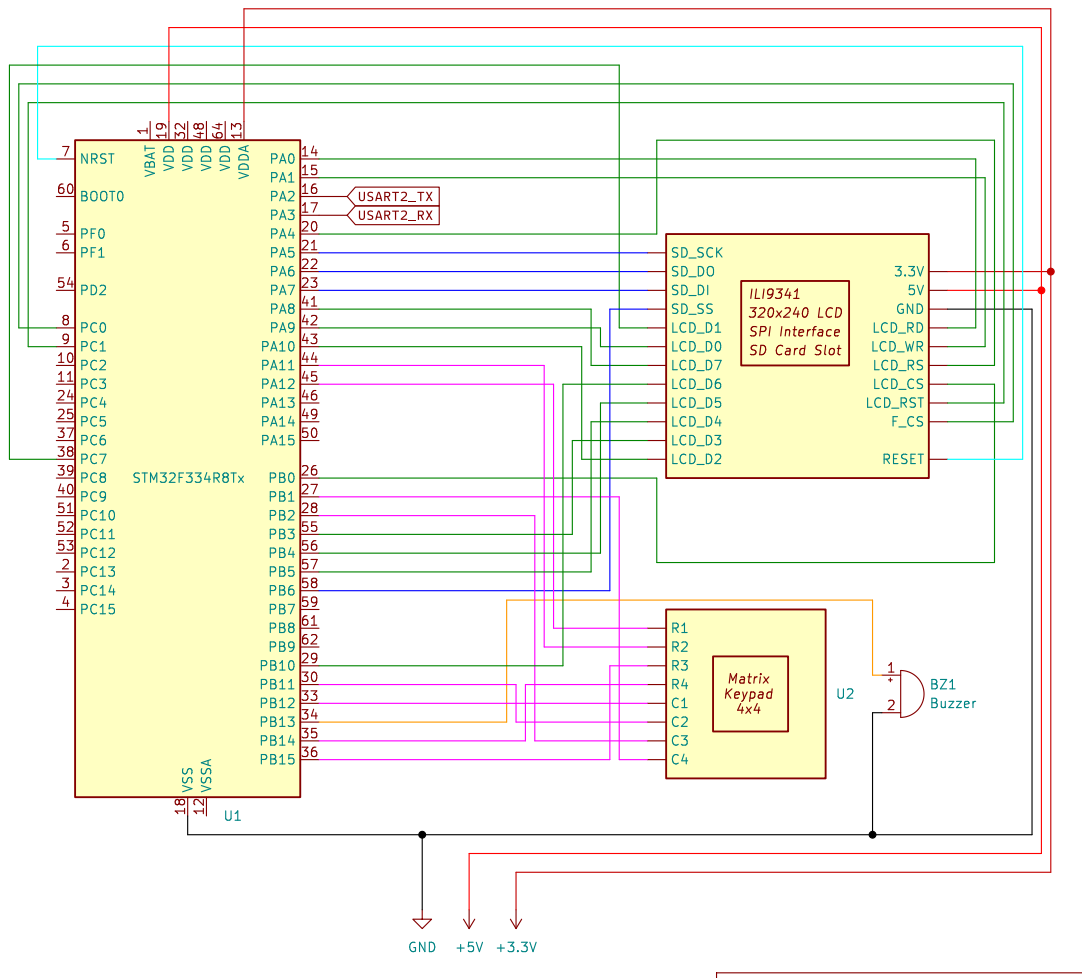
[picture p22: page 1]

ILI9341
SD Card Slot SPI Interface

File: STM32_CHIP8.kicad_sch Sheet: / Chip-8-Org GND +5V +3.3V
