CHIP-8-Org/Docs/report/figures/matrix_font.pdf

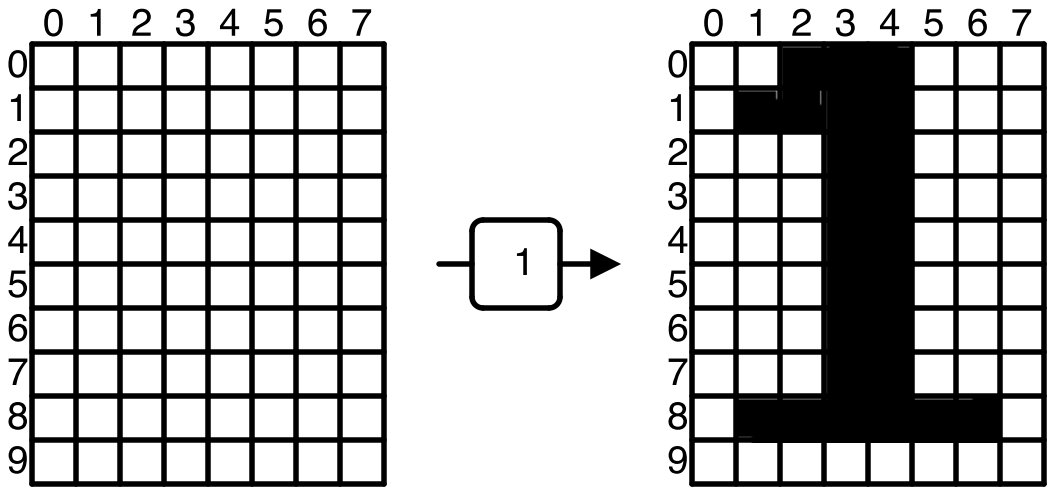
[picture p47: page 1]
