CHIP-8-Org/Docs/report/figures/screenopt_small.pdf

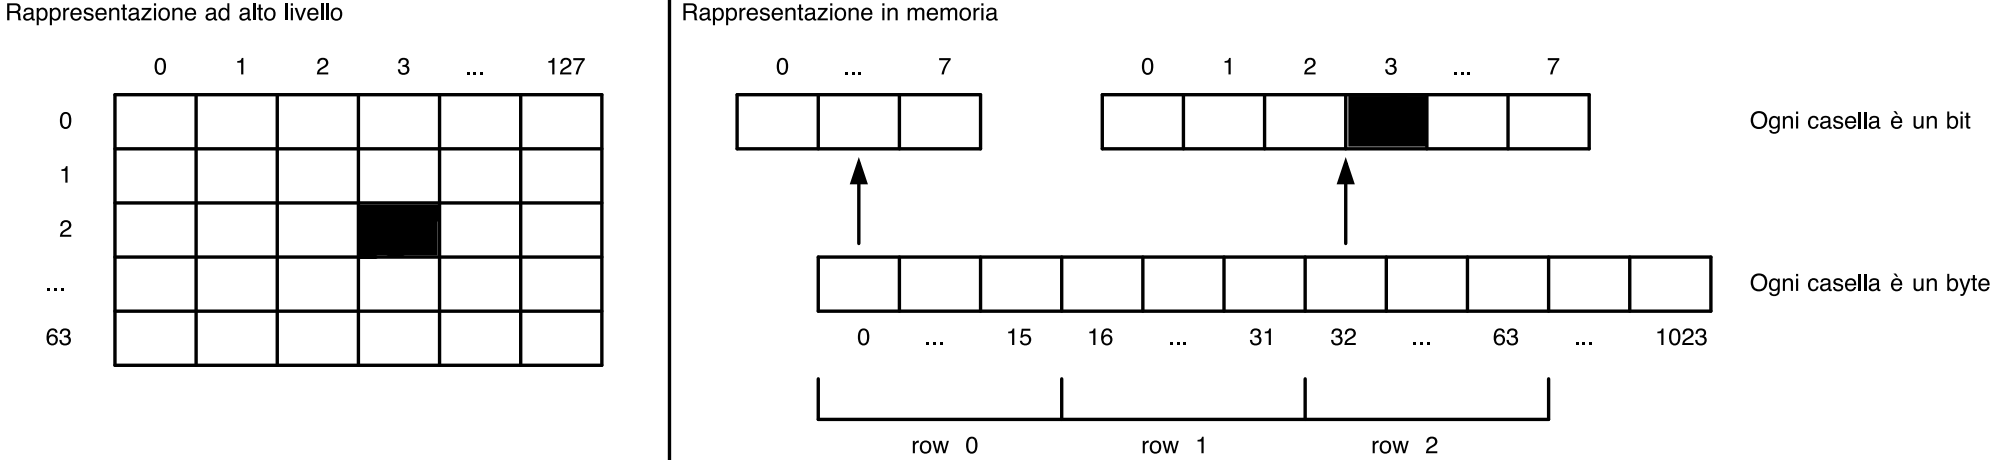
[picture p48: page 1]
