CHIP-8-Org/Docs/(commit log)

2024-02-09 Add `schematic` (kikad project)
    [STM32_CHIP8.kicad_pcb, STM32_CHIP8.kicad_sch]
2024-02-23 Add assemblaggio part
